PurpleCactus2/Custom-Devboard/Assets/PCB/PCB Render2.png

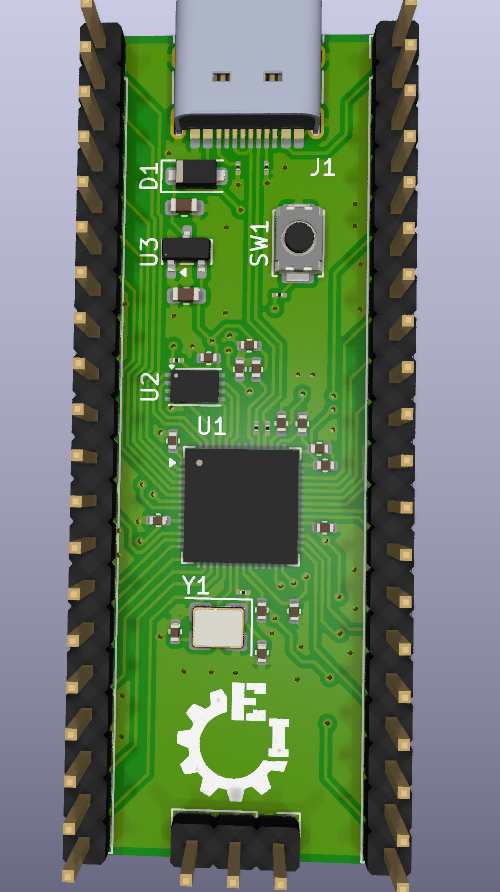
Assets/PCB/PCB Render2.png
