PurpleCactus2/Custom-Devboard/Assets/PCB/PCB Render3.png

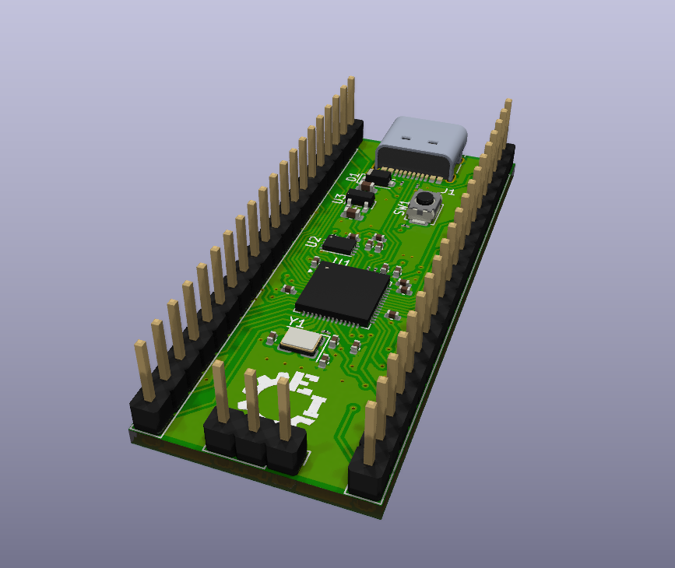
Assets/PCB/PCB Render3.png
