PurpleCactus2/Custom-Devboard/README.md

# Custom-Devboard
An RP2040 devboard meant for a completely custom and streamlined electronics development experience!
PCB Render1

## Introduction
This is a completely custom devboard made with the wonderful guide by [@Kai Pereira](https://blueprint.hackclub.com/starter-projects/devboard)

It features:

- An RP2040 microcontroller
- All 30 GPIO pins of the RP2040 broken out, with plently power and debugging pins as well
- 2MB of flash storage

## PCB and Schematic

### Schematic
My schematic uses a mostly similar layout to the one suggested in the guide, however, I have also included a diode and VSYS pin so that you can connect an external battery/power source to power the board. In addition to this, I have also changed the external pin layout a little in a way that makes more sense to me, but you'll see what I mean.

Here are a couple of screenshots of the schematic:

The RP2040 with its decoupling capacitors:<br>
Microcontroller<br>

The USB-C port (you can also see the diode I added here):<br>
USB-C<br>

The flash memory along with the BOOTSEL button:<br>
Flash<br>

The 12MHz crystal oscillator:<br>
Crystal<br>

The IO pins with a slightly changed layout:<br>
IO<br>

### PCB
This is my first time using SMD so my layout and routing are a little atrocious. But I have tried my best to keep everything as logical as possible.

Here are a couple screenshots of the PCB:

The RP2040 footprint with decoupling caps, crystal and flash:<br>
MCU Screenshot<br>

The whole board:<br>
Board Screenshot<br>

Final render:<br>
PCB Render2<br>

## BOM
|  | Item | Qty | Supplier | Cost/item | Total Cost | link |
|---|---|---|---|---|---|---|
|  | RP2040 | 1 | LCSC | $1.10 | $1.10 | [LCSC](https://www.lcsc.com/product-detail/C2040.html) |
|  | MCP1700 | 1 | LCSC | $0.44 | $0.44 | [LCSC](https://www.lcsc.com/product-detail/C39051.html) |
|  | Crystal | 1 | LCSC | $0.46 | $0.46 | [LCSC](https://www.lcsc.com/product-detail/C9002.html) |
|  | Flash memory | 1 | LCSC | $1.92 | $1.92 | [LCSC](https://www.lcsc.com/product-detail/C2456208.html) |
|  | Button | 1 | LCSC | $0.51 | $0.51 | [LCSC](https://www.lcsc.com/product-detail/C720477.html) |
|  | USB-C Port | 1 | LCSC | $0.87 | $0.87 | [LCSC](https://www.lcsc.com/product-detail/C165948.html) |
|  | Passive Components | 1 | LCSC | $1.57 | $1.57 | [100nF](https://www.lcsc.com/product-detail/C1525.html) [1uF](https://www.lcsc.com/product-detail/C2803380.html) [10uF](https://www.lcsc.com/product-detail/C1691.html) [33pF](https://www.lcsc.com/product-detail/C107005.html) [Diode](https://www.lcsc.com/product-detail/C49231016.html) [5.1KΩ](https://www.lcsc.com/product-detail/C2906874.html) [27Ω](https://www.lcsc.com/product-detail/C2909343.html) [1KΩ](https://www.lcsc.com/product-detail/C2906899.html) [10KΩ](https://www.lcsc.com/product-detail/C2906861.html) |
|  | PCB | 1 | JLCPCB | $4.10 | $4.10 | [LCSC](https://cart.jlcpcb.com/quote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) |
|  | Estimated total shipping |  |  |  | $18.94 |  |
|  | Total |  |  |  | $29.91 |  |

*I am willing to cover any extra charges that might apply*

### Cart Screenshots

LCSC Order:<br>
LCSC1<br>
LCSC2<br>
LCSC3<br>

JLCPCB Order:<br>
JLCPCB
