PurpleCactus2/Custom-Devboard/Assets/Cart Screenshots/JLCPCB.png

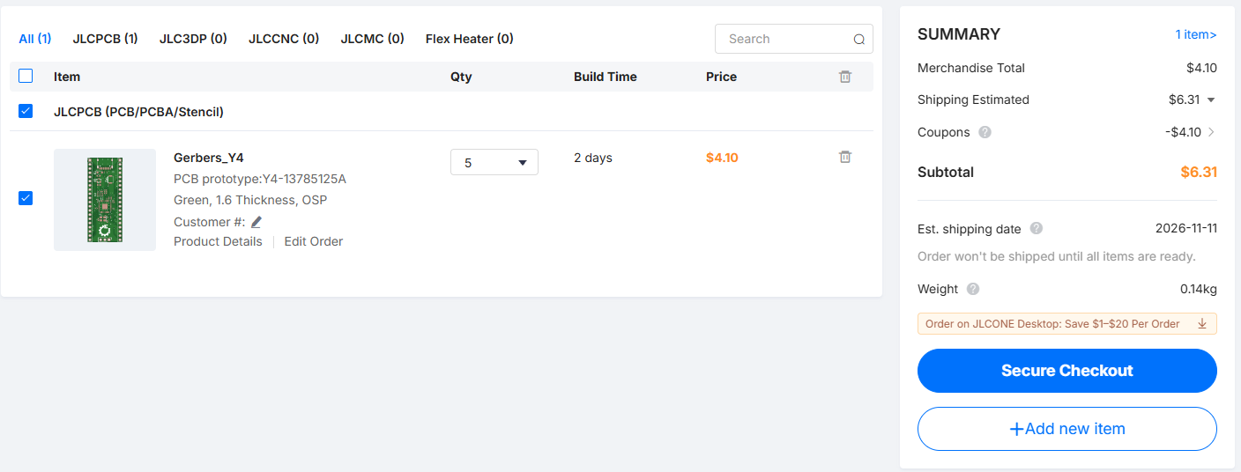
Assets/Cart Screenshots/JLCPCB.png
