PurpleCactus2/Custom-Devboard/Assets/Cart Screenshots/LCSC1.png

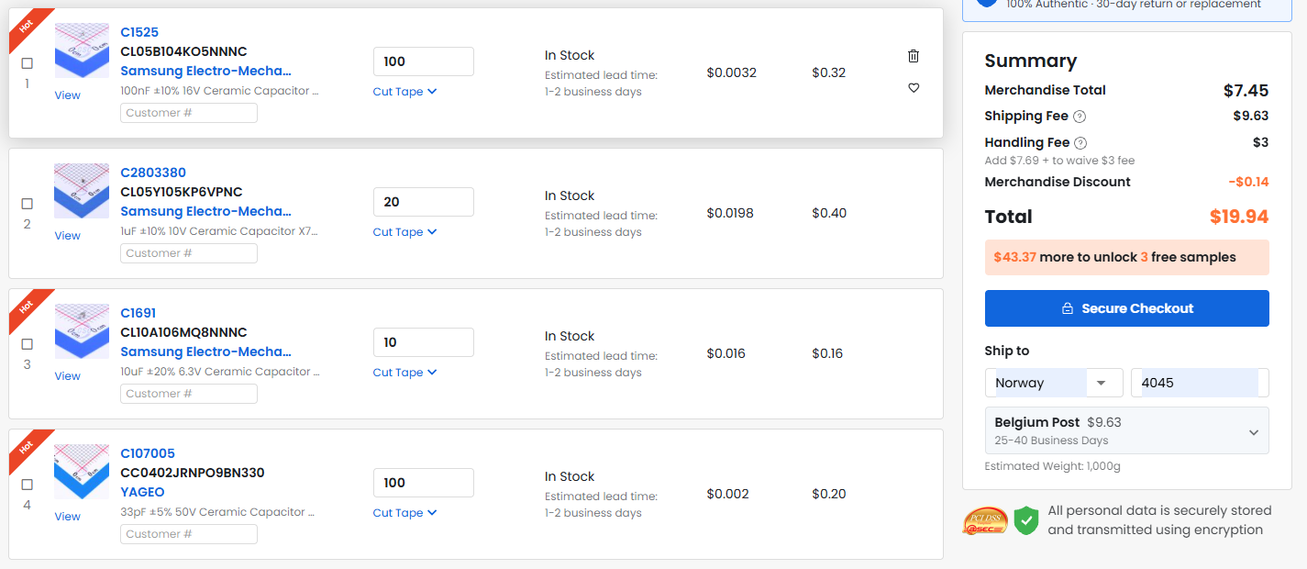
Assets/Cart Screenshots/LCSC1.png
