PurpleCactus2/Custom-Devboard/Assets/Cart Screenshots/LCSC2.png

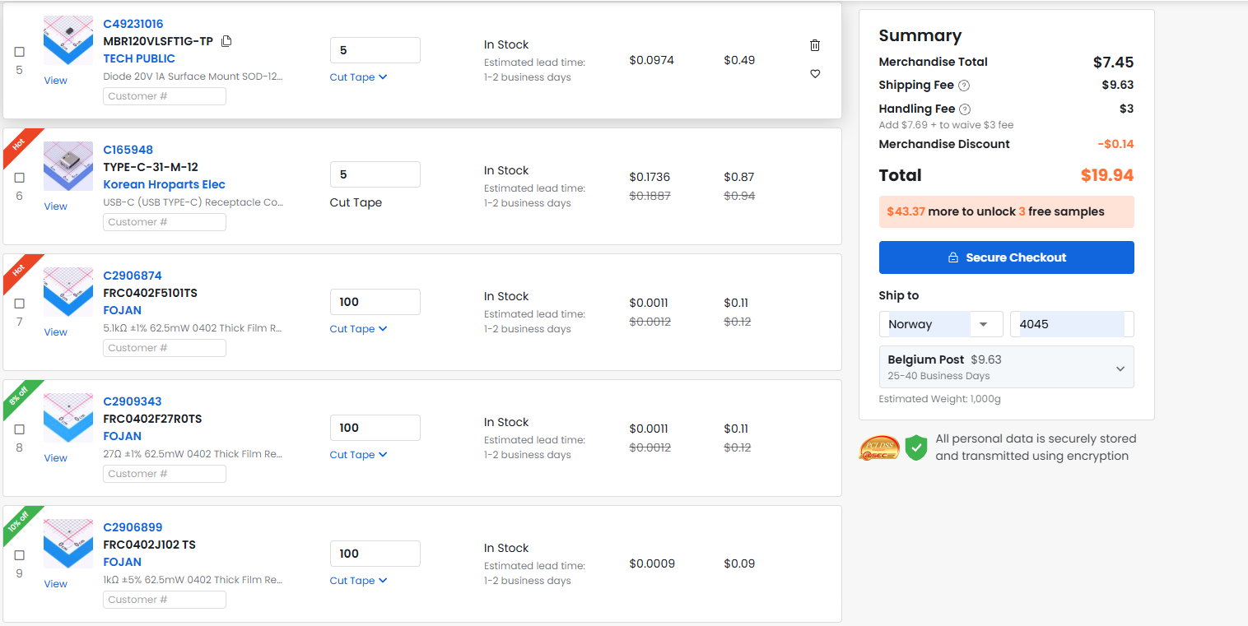
Assets/Cart Screenshots/LCSC2.png
