PurpleCactus2/Custom-Devboard/Assets/Cart Screenshots/LCSC3.png

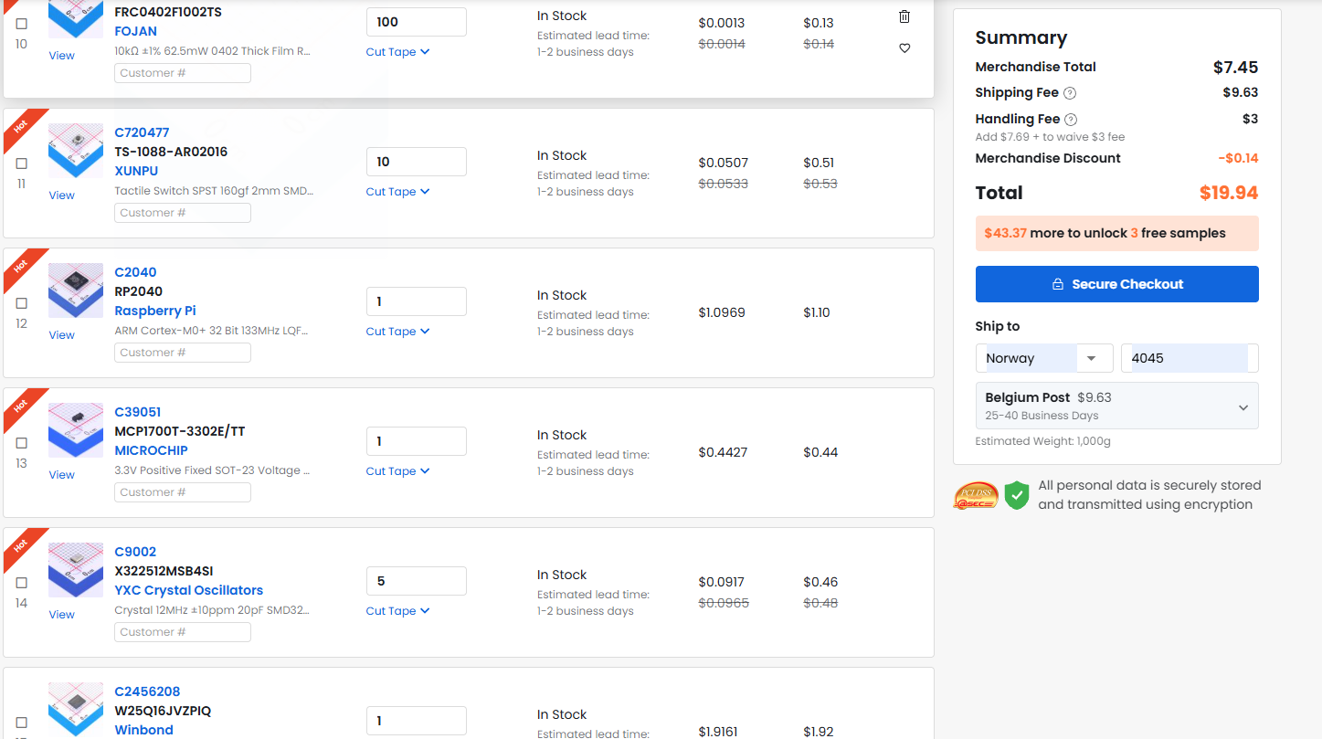
Assets/Cart Screenshots/LCSC3.png
