PurpleCactus2/Custom-Devboard/Assets/PCB/Board Screenshot .png

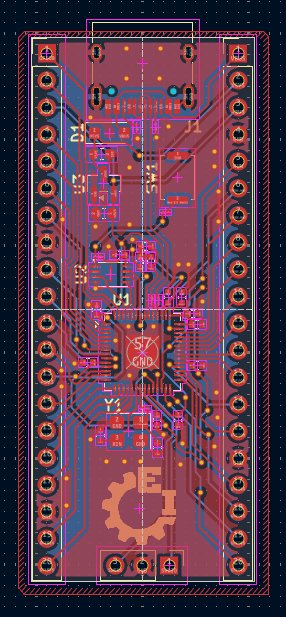
Assets/PCB/Board Screenshot .png
