PurpleCactus2/Custom-Devboard/Assets/PCB/MCU Screenshot.png

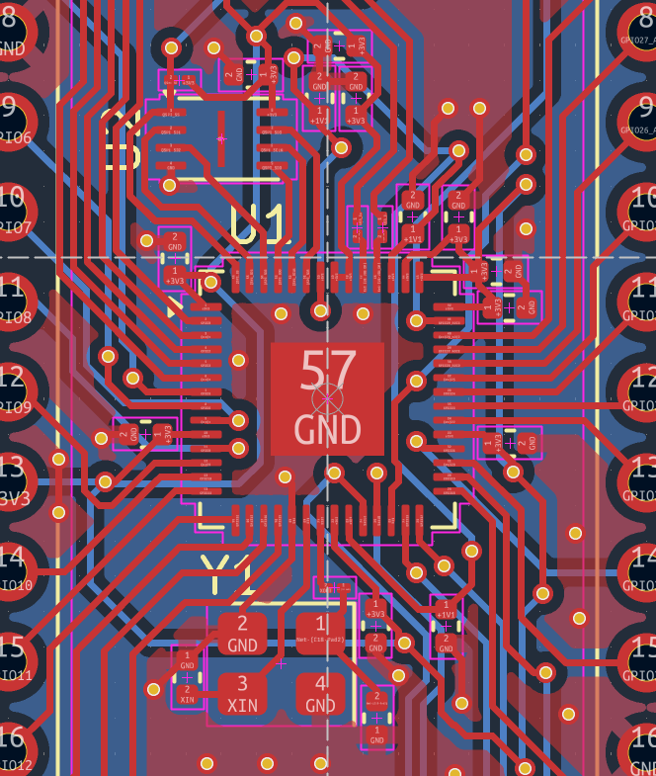
Assets/PCB/MCU Screenshot.png
