PurpleCactus2/Custom-Devboard/Assets/PCB/PCB Render1.png

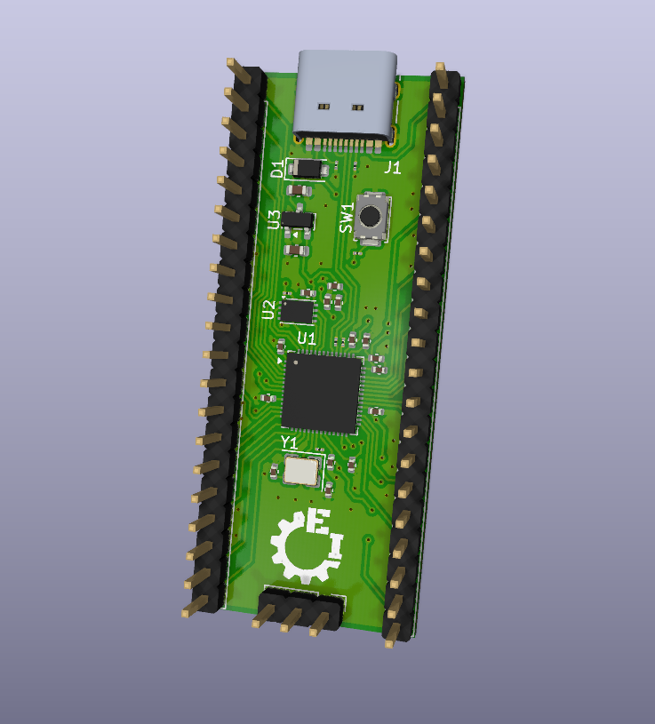
Assets/PCB/PCB Render1.png
