PurpleCactus2/Custom-Devboard/Assets/Schematic/Crystal.png

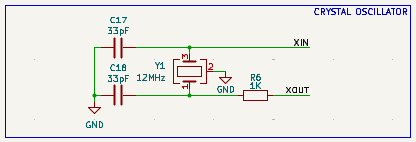
Assets/Schematic/Crystal.png
