PurpleCactus2/Custom-Devboard/Assets/Schematic/Flash.png

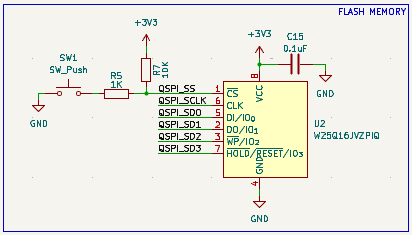
Assets/Schematic/Flash.png
