PurpleCactus2/Custom-Devboard/Assets/Schematic/IO.png

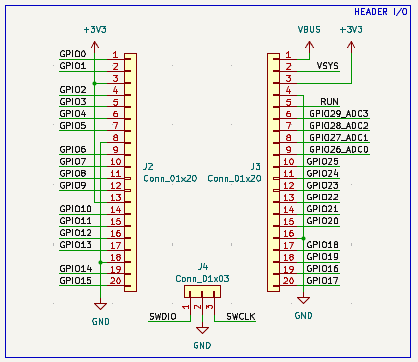
Assets/Schematic/IO.png
