PurpleCactus2/Custom-Devboard/Assets/Schematic/Microcontroller.png

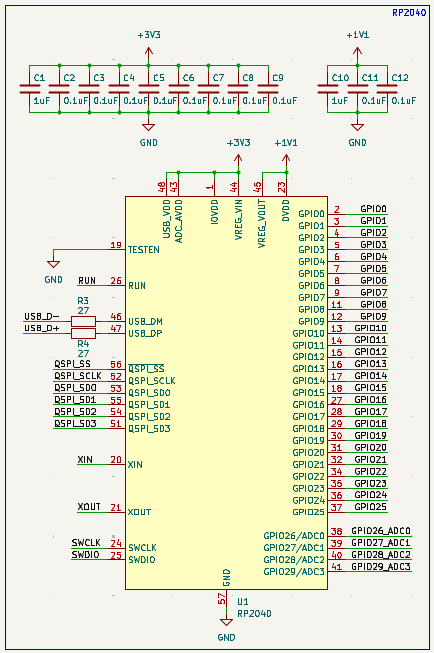
Assets/Schematic/Microcontroller.png
