PurpleCactus2/Custom-Devboard/Assets/Schematic/USB-C.png

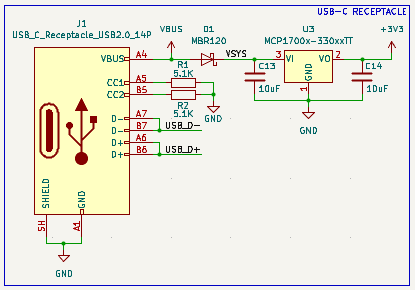
Assets/Schematic/USB-C.png
