PurpleCactus2/Custom-Devboard/BOM.csv

Item | Qty | Supplier | Cost/item | Total Cost | link
RP2040 | 1 | LCSC | $1.10 | $1.10 | https://www.lcsc.com/product-detail/C2040.html
MCP1700 | 1 | LCSC | $0.44 | $0.44 | https://www.lcsc.com/product-detail/C39051.html
Crystal | 1 | LCSC | $0.46 | $0.46 | https://www.lcsc.com/product-detail/C9002.html
Flash memory | 1 | LCSC | $1.92 | $1.92 | https://www.lcsc.com/product-detail/C2456208.html
Button | 1 | LCSC | $0.51 | $0.51 | https://www.lcsc.com/product-detail/C720477.html
USB-C Port | 1 | LCSC | $0.87 | $0.87 | https://www.lcsc.com/product-detail/C165948.html
Passive Components | 1 | LCSC | $1.57 | $1.57 | https://www.lcsc.com/product-detail/C1525.html
PCB | 1 | JLCPCB | $4.10 | $4.10 | https://cart.jlcpcb.com/quote?stencilLayer=2&stencilWidth=100&stencilLength=100&stencilCounts=5&plateType=1
Estimated total shipping | 1 |  |  | $18.94
