PurpleCactus2/Custom-Devboard/Assets/Cart Screenshots/LCSC Cart.csv

Index | LCSC# | MPN | Manufacturer | Package | Customer # | Description | RoHS | Quantity | MOQ | Multiple | Unit Price($) | Extended Price($) | Product Link
1 | C1525 | CL05B104KO5NNNC | Samsung Electro-Mechanics | 0402 |  | 100nF ±10% 16V Ceramic Capacitor X7R 0402 | yes | 100 | 100 | 100 | 0.0032 | 0.32 | https://www.lcsc.com/product-detail/C1525.html
2 | C2803380 | CL05Y105KP6VPNC | Samsung Electro-Mechanics | 0402 |  | 1uF ±10% 10V Ceramic Capacitor X7S 0402 | yes | 20 | 20 | 20 | 0.0198 | 0.40 | https://www.lcsc.com/product-detail/C2803380.html
3 | C1691 | CL10A106MQ8NNNC | Samsung Electro-Mechanics | 0603 |  | 10uF ±20% 6.3V Ceramic Capacitor X5R 0603 | yes | 10 | 10 | 10 | 0.0160 | 0.16 | https://www.lcsc.com/product-detail/C1691.html
4 | C107005 | CC0402JRNPO9BN330 | YAGEO | 0402 |  | 33pF ±5% 50V Ceramic Capacitor NP0 0402 | yes | 100 | 100 | 100 | 0.0020 | 0.20 | https://www.lcsc.com/product-detail/C107005.html
5 | C49231016 | MBR120VLSFT1G-TP | TECH PUBLIC | SOD-123F |  | Diode 20V 1A Surface Mount SOD-123F | yes | 5 | 5 | 5 | 0.0974 | 0.49 | https://www.lcsc.com/product-detail/C49231016.html
6 | C165948 | TYPE-C-31-M-12 | Korean Hroparts Elec | SMD |  | USB-C (USB TYPE-C) Receptacle Connector 16 Position Surface Mount | yes | 5 | 5 | 5 | 0.1736 | 0.87 | https://www.lcsc.com/product-detail/C165948.html
7 | C2906874 | FRC0402F5101TS | FOJAN | 0402 |  | 5.1kΩ ±1% 62.5mW 0402 Thick Film Resistor | yes | 100 | 100 | 100 | 0.0011 | 0.11 | https://www.lcsc.com/product-detail/C2906874.html
8 | C2909343 | FRC0402F27R0TS | FOJAN | 0402 |  | 27Ω ±1% 62.5mW 0402 Thick Film Resistor | yes | 100 | 100 | 100 | 0.0011 | 0.11 | https://www.lcsc.com/product-detail/C2909343.html
9 | C2906899 | FRC0402J102 TS | FOJAN | 0402 |  | 1kΩ ±5% 62.5mW 0402 Thick Film Resistor | yes | 100 | 100 | 100 | 0.0009 | 0.09 | https://www.lcsc.com/product-detail/C2906899.html
10 | C2906861 | FRC0402F1002TS | FOJAN | 0402 |  | 10kΩ ±1% 62.5mW 0402 Thick Film Resistor | yes | 100 | 100 | 100 | 0.0013 | 0.13 | https://www.lcsc.com/product-detail/C2906861.html
11 | C720477 | TS-1088-AR02016 | XUNPU | SMD,4x3mm |  | Tactile Switch SPST 160gf 2mm SMD (SMT) Tab 4mm x 3mm Surface Mount | yes | 10 | 10 | 10 | 0.0507 | 0.51 | https://www.lcsc.com/product-detail/C720477.html
12 | C2040 | RP2040 | Raspberry Pi | LQFN-56(7x7) |  | ARM Cortex-M0+ 32 Bit 133MHz LQFN-56(7x7) Microcontrollers | yes | 1 | 1 | 1 | 1.0969 | 1.10 | https://www.lcsc.com/product-detail/C2040.html
13 | C39051 | MCP1700T-3302E/TT | MICROCHIP | SOT-23 |  | 3.3V Positive Fixed SOT-23 Voltage Regulators - Linear, Low Drop Out (LDO) Regulators RoHS | yes | 1 | 1 | 1 | 0.4427 | 0.44 | https://www.lcsc.com/product-detail/C39051.html
14 | C9002 | X322512MSB4SI | YXC Crystal Oscillators | SMD3225-4P |  | Crystal 12MHz ±10ppm 20pF SMD3225-4P | yes | 5 | 5 | 5 | 0.0917 | 0.46 | https://www.lcsc.com/product-detail/C9002.html
15 | C2456208 | W25Q16JVZPIQ | Winbond | WSON-8-EP(5x6) |  | 16Mbit 2.7V~3.6V 133MHz SPI WSON-8-EP(5x6) Memory RoHS | yes | 1 | 1 | 1 | 1.9161 | 1.92 | https://www.lcsc.com/product-detail/C2456208.html
