PurpleCactus2/Custom-Devboard/PCB/SchematicPDF.pdf

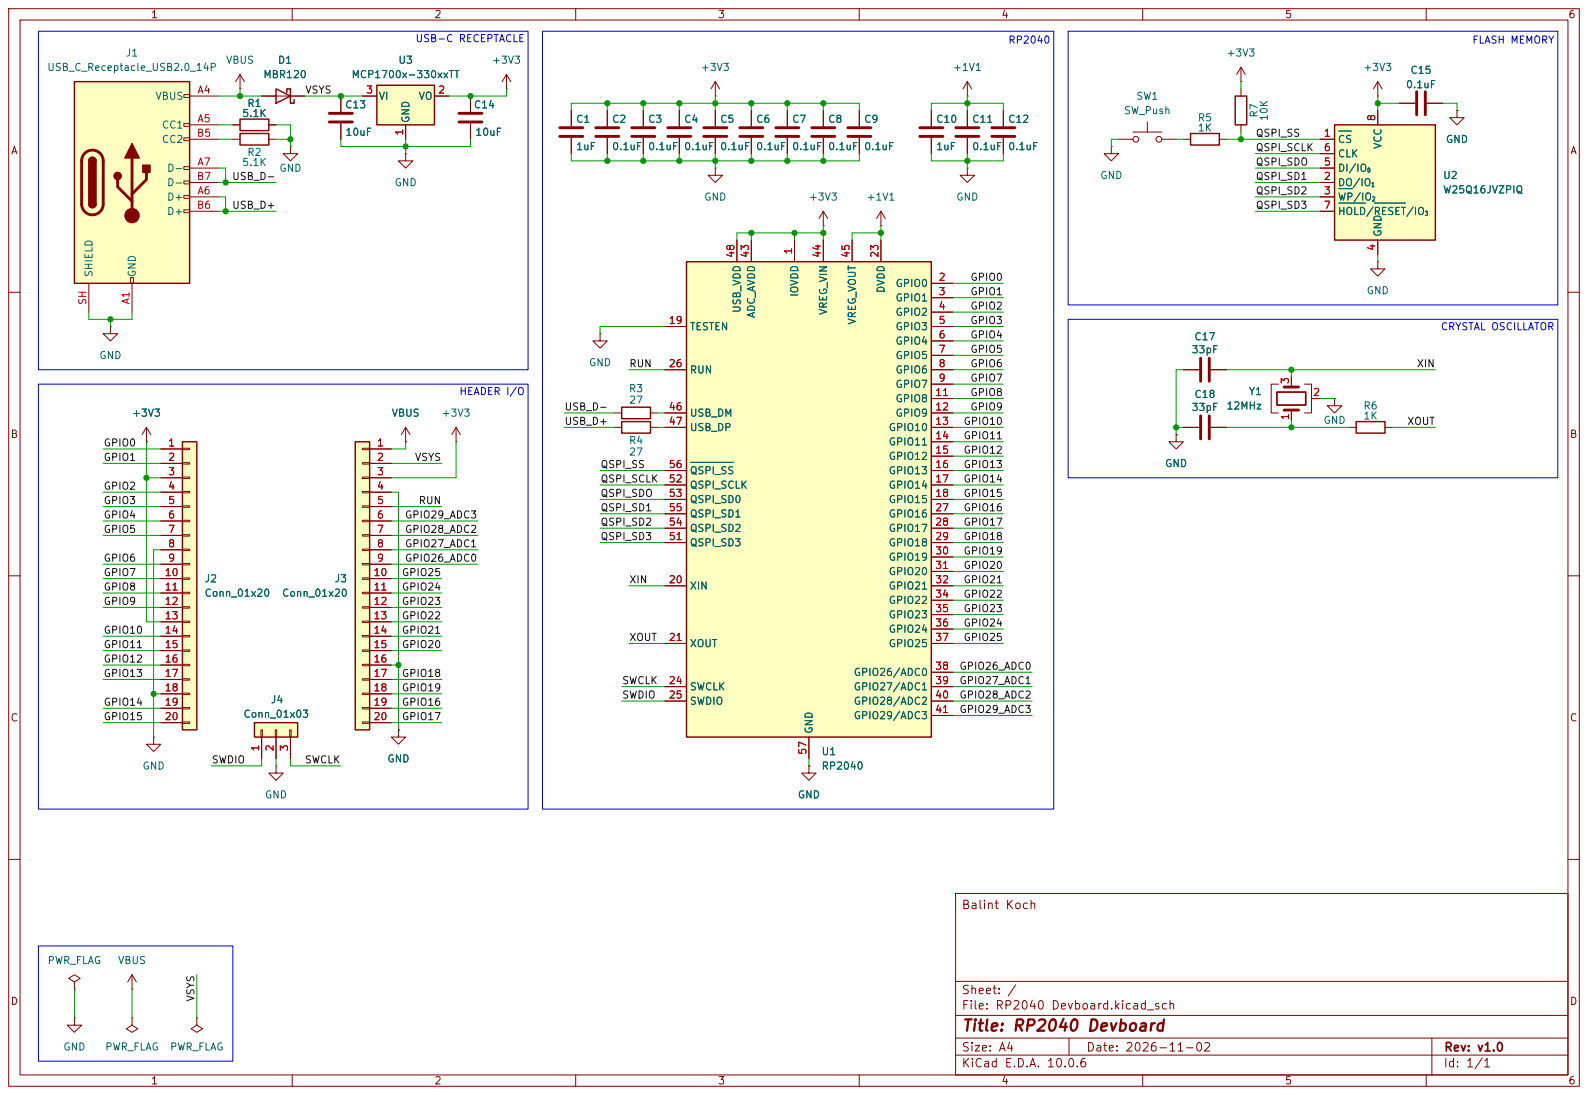
[picture p15: page 1]

4 DI/IO0 5 CLK 6 HOLD/RESET/IO3 7 VCC

PWR_FLAG GND | VBUS PWR_FLAG

Size: A4 | Rev: v1.0
KiCad E.D.A. 10.0.6 | Id: 1/1
