PurpleCactus2/Custom-Devboard/PCB/Devboard PCB.kicad_pcb

## KiCad design PCB/Devboard PCB.kicad_pcb (2026-11-09)

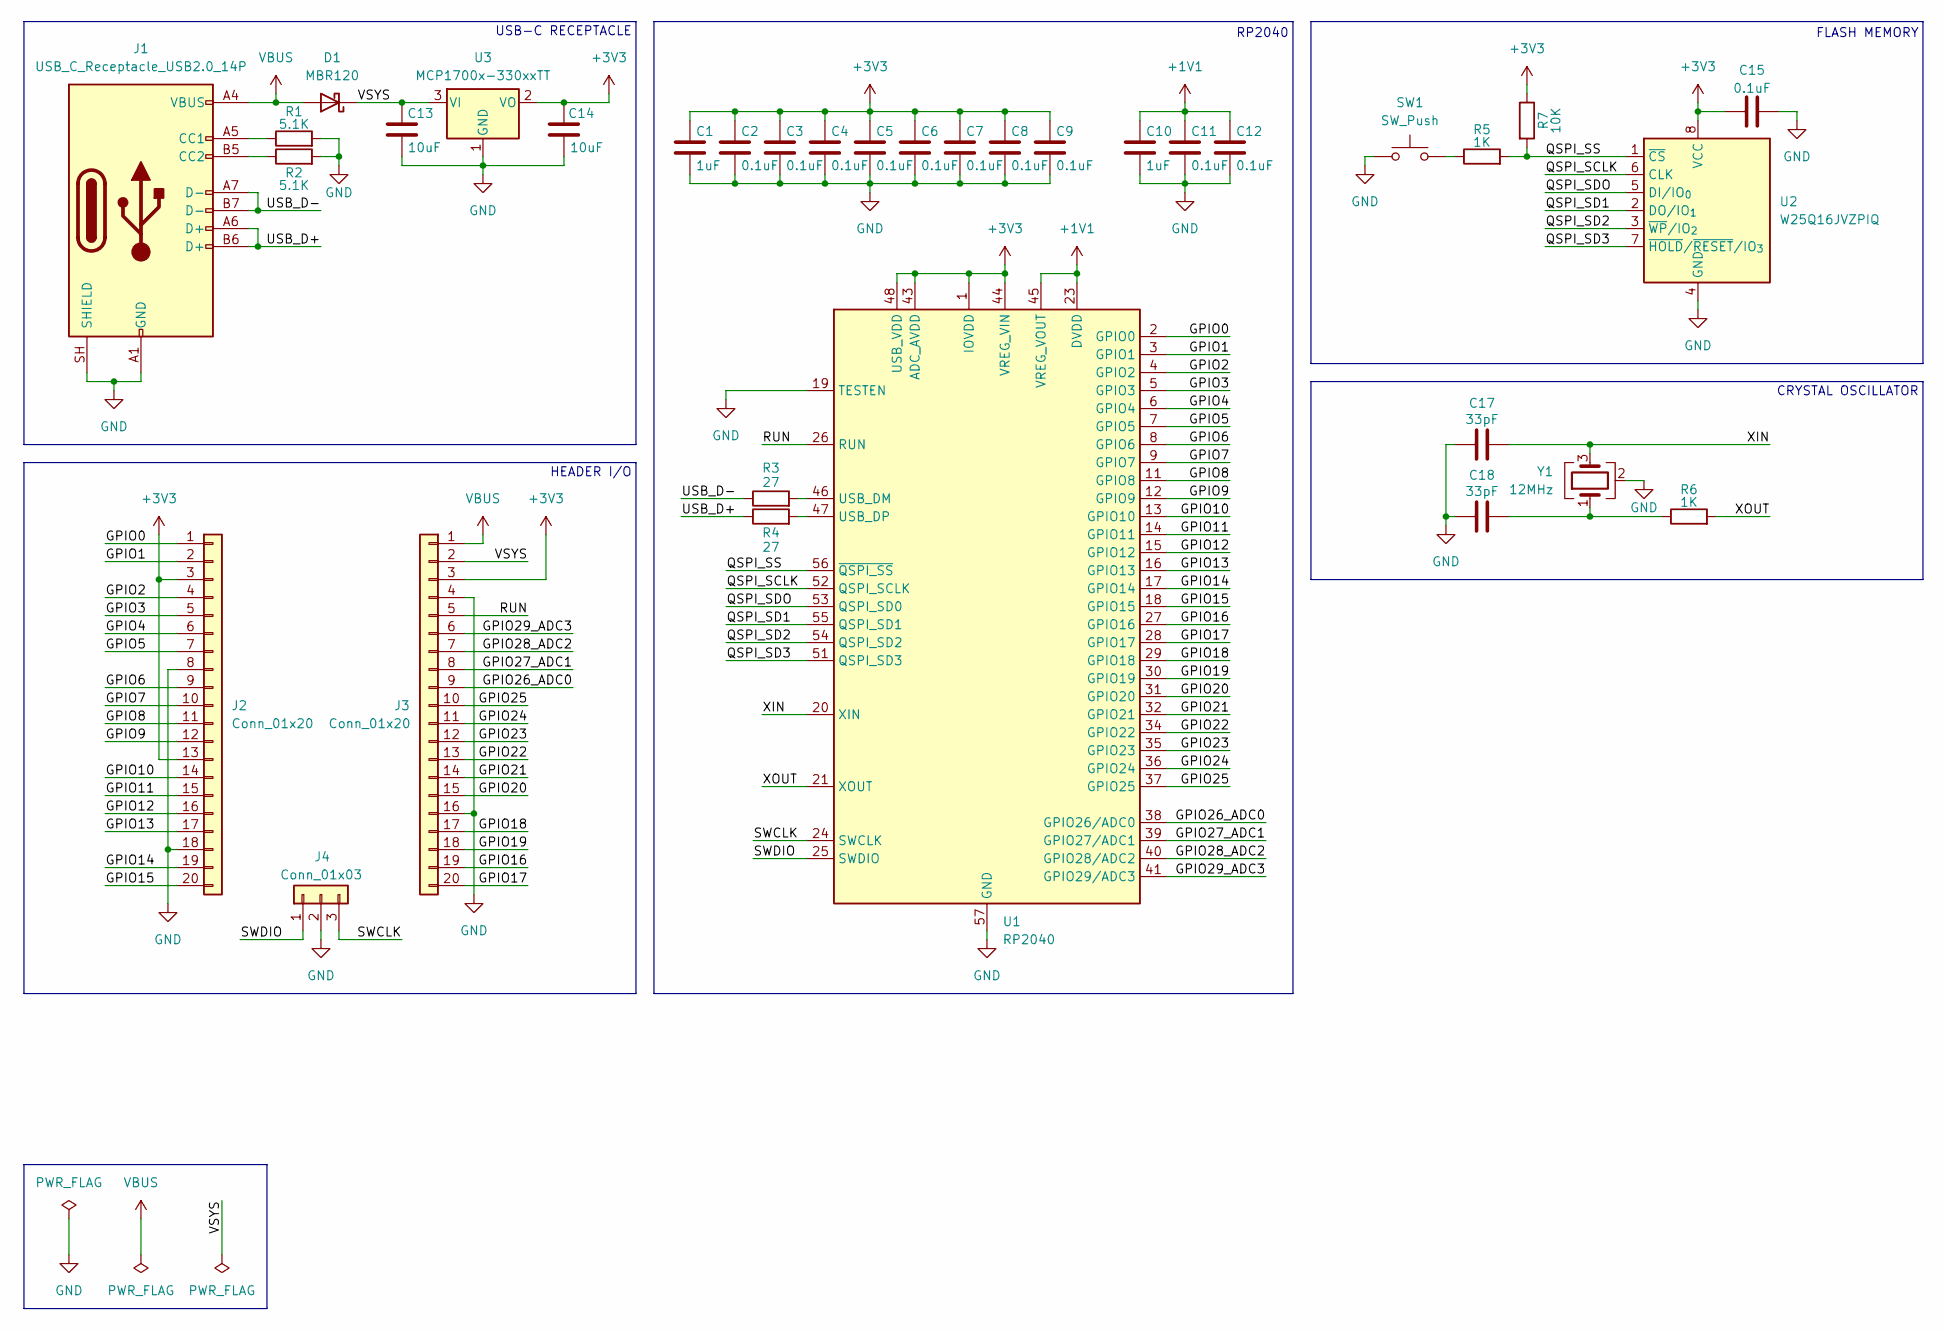
[picture p16: schematic Devboard Schematic.kicad_sch, RP2040 Devboard]

Parts:
C1, C10: 1uF; C_0402_1005Metric
C2, C3, C4, C5, C6, C7, C8, C9, C11, C12, C15: 0.1uF; C_0402_1005Metric
C13, C14: 10uF; C_0603_1608Metric
C17, C18: 33pF; C_0402_1005Metric
D1: MBR120; D_SOD-123F
J1: USB_C_Receptacle_USB2.0_14P; USB_C_Receptacle_HRO_TYPE-C-31-M-12
J2, J3: Conn_01x20; PinHeader_1x20_P2.54mm_Vertical
J4: Conn_01x03; PinHeader_1x03_P2.54mm_Vertical
R1, R2: 5.1K; R_01005_0402Metric
R3, R4: 27; R_01005_0402Metric
R5, R6: 1K; R_01005_0402Metric
R7: 10K; R_01005_0402Metric
SW1: SW_Push; SW_Push_SPST_NO_Alps_SKRK
U1: RP2040; QFN-56-1EP_7x7mm_P0.4mm_EP3.2x3.2mm
U2: W25Q16JVZPIQ; Winbond_USON-8-1EP_3x2mm_P0.5mm_EP0.2x1.6mm
U3: MCP1700x-330xxTT; SOT-23
Y1: 12MHz; Crystal_SMD_3225-4Pin_3.2x2.5mm

Connections:
+1V1: C10.1, C11.1, C12.1, U1.23 (DVDD), U1.45 (VREG_VOUT), U1.50 (DVDD)
+3V3: C1.1, C2.1, C3.1, C4.1, C5.1, C6.1, C7.1, C8.1, C9.1, C14.1, C15.1, J2.3, J2.13, J3.3, R7.1, U1.1 (IOVDD), U1.10 (IOVDD), U1.22 (IOVDD), U1.33 (IOVDD), U1.42 (IOVDD), U1.43 (ADC_AVDD), U1.44 (VREG_VIN), U1.48 (USB_VDD), U1.49 (IOVDD), U2.8 (VCC), U3.2 (VO)
/GPIO0: J2.1, U1.2 (GPIO0)
/GPIO1: J2.2, U1.3 (GPIO1)
/GPIO2: J2.4, U1.4 (GPIO2)
/GPIO3: J2.5, U1.5 (GPIO3)
/GPIO4: J2.6, U1.6 (GPIO4)
/GPIO5: J2.7, U1.7 (GPIO5)
/GPIO6: J2.9, U1.8 (GPIO6)
/GPIO7: J2.10, U1.9 (GPIO7)
/GPIO8: J2.11, U1.11 (GPIO8)
/GPIO9: J2.12, U1.12 (GPIO9)
/GPIO10: J2.14, U1.13 (GPIO10)
/GPIO11: J2.15, U1.14 (GPIO11)
/GPIO12: J2.16, U1.15 (GPIO12)
/GPIO13: J2.17, U1.16 (GPIO13)
/GPIO14: J2.19, U1.17 (GPIO14)
/GPIO15: J2.20, U1.18 (GPIO15)
/GPIO16: J3.19, U1.27 (GPIO16)
/GPIO17: J3.20, U1.28 (GPIO17)
/GPIO18: J3.17, U1.29 (GPIO18)
/GPIO19: J3.18, U1.30 (GPIO19)
/GPIO20: J3.15, U1.31 (GPIO20)
/GPIO21: J3.14, U1.32 (GPIO21)
/GPIO22: J3.13, U1.34 (GPIO22)
/GPIO23: J3.12, U1.35 (GPIO23)
/GPIO24: J3.11, U1.36 (GPIO24)
/GPIO25: J3.10, U1.37 (GPIO25)
/GPIO26_ADC0: J3.9, U1.38 (GPIO26/ADC0)
/GPIO27_ADC1: J3.8, U1.39 (GPIO27/ADC1)
/GPIO28_ADC2: J3.7, U1.40 (GPIO28/ADC2)
/GPIO29_ADC3: J3.6, U1.41 (GPIO29/ADC3)
/QSPI_SCLK: U1.52 (QSPI_SCLK), U2.6 (CLK)
/QSPI_SD1: U1.55 (QSPI_SD1), U2.2 (DO/IO_{1})
/QSPI_SD2: U1.54 (QSPI_SD2), U2.3 (~WP/IO_{2})
/QSPI_SD3: U1.51 (QSPI_SD3), U2.7 (~HOLD/~RESET/IO_{3})
/QSPI_SDO: U1.53 (QSPI_SD0), U2.5 (DI/IO_{0})
/QSPI_SS: R5.2, R7.2, U1.56 (~QSPI_SS), U2.1 (~CS)
/RUN: J3.5, U1.26 (RUN)
/SWCLK: J4.3, U1.24 (SWCLK)
/SWDIO: J4.1, U1.25 (SWDIO)
/USB_D+: J1.A6 (D+), J1.B6 (D+), R4.1
/USB_D-: J1.A7 (D-), J1.B7 (D-), R3.1
/VSYS: C13.1, D1.1 (K), J3.2, U3.3 (VI)
/XIN: C17.2, U1.20 (XIN), Y1.3
/XOUT: R6.2, U1.21 (XOUT)
GND: C1.2, C2.2, C3.2, C4.2, C5.2, C6.2, C7.2, C8.2, C9.2, C10.2, C11.2, C12.2, C13.2, C14.2, C15.2, C17.1, C18.1, J1.A1 (GND), J1.A12 (GND), J1.B1 (GND), J1.B12 (GND), J1.SH (SHIELD), J2.8, J2.18, J3.4, J3.16, J4.2, R1.2, R2.2, SW1.1, U1.19 (TESTEN), U1.57 (GND), U2.4 (GND), U3.1 (GND), Y1.2 (G), Y1.4 (G)
unnamed: C18.2, R6.1, Y1.1
unnamed: J1.A5 (CC1), R1.1
unnamed: J1.B5 (CC2), R2.1
unnamed: R5.1, SW1.2
unnamed: R3.2, U1.46 (USB_DM)
unnamed: R4.2, U1.47 (USB_DP)
VBUS: D1.2 (A), J1.A4 (VBUS), J1.A9 (VBUS), J1.B4 (VBUS), J1.B9 (VBUS), J3.1

Notes on the sheet:
USB-C RECEPTACLE
HEADER I/O
RP2040
CRYSTAL OSCILLATOR
FLASH MEMORY

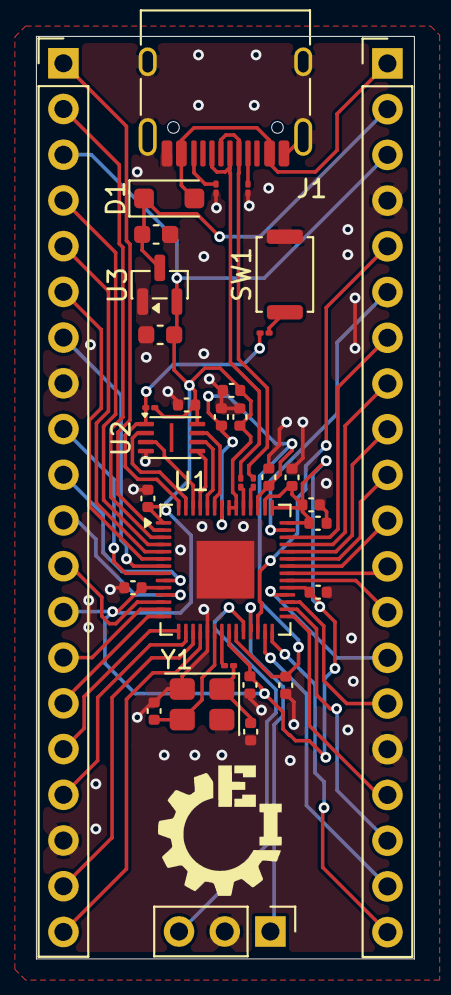
[picture p17: board Devboard PCB.kicad_pcb from above]

Board: 2 copper layers, 21.0 x 51.2 mm, 34 parts (0 on the bottom side), 54 nets.
