PurpleCactus2/Custom-Devboard/JOURNAL.md

# Custom Devboard: devlog

<!-- Generated by Half Life from project da2gd1uc3pobl39w0nm68g7f. Edits here are overwritten on the next sync. -->
<!-- Generated: 2026-11-09T01:05:24.286Z -->

> [!NOTE]
> This devlog is mirrored from [Half Life](https://halflife.hackclub.com) ([open the project](https://halflife.hackclub.com/projects/da2gd1uc3pobl39w0nm68g7f)). Editing it here will not change the platform's copy, and the next sync overwrites this file.

> An RP2040 devboard meant for a completely custom and streamlined electronics development experience!

| Week | Tier | Hours logged | Entries |
| --- | --- | --- | --- |
| Week 5 | Tier 1 | 18.32h | 8 |

## Contents

1. [2026-11-02: Starting the schematic and researching components](#2026-11-02-starting-the-schematic-and-researching-components)
2. [2026-11-03: Working more on the schematic, at this point I  am thinking about battery power integration and pin layout options](#2026-11-03-working-more-on-the-schematic-at-this-point-i-am-)
3. [2026-11-05: Finishing the schematic itself, footprints still need to be added though.](#2026-11-05-finishing-the-schematic-itself-footprints-still-n)
4. [2026-11-06: Assigning all footprints and researching components](#2026-11-06-assigning-all-footprints-and-researching-componen)
5. [2026-11-06: Starting the PCB itself; making the rough layout](#2026-11-06-starting-the-pcb-itself-making-the-rough-layout)
6. [2026-11-07: Figuring out the layout and making a draft before routing](#2026-11-07-figuring-out-the-layout-and-making-a-draft-before)
7. [2026-11-08: Completely routing and finishing the PCB, also exporting screenshots and production files](#2026-11-08-completely-routing-and-finishing-the-pcb-also-exp)
8. [2026-11-08: Creating the BOM, finishing up the repo](#2026-11-08-creating-the-bom-finishing-up-the-repo)

## Design

### 2026-11-02: Starting the schematic and researching components

**1.42h**

Starting the schematic and researching components

[Timelapse](https://lookout.hackclub.com/api/media/925ab663-7c3c-4cf1-8395-ae1f1cbb7657/video.mp4)

### 2026-11-03: Working more on the schematic, at this point I  am thinking about battery power integration and pin layout options

**1.87h**

Working more on the schematic, at this point I  am thinking about battery power integration and pin layout options

[Timelapse](https://lookout.hackclub.com/api/media/6d62385f-a4f2-4cc5-9b7e-b176e370cad0/video.mp4)

### 2026-11-05: Finishing the schematic itself, footprints still need to be added though.

**1.83h**

Finishing the schematic itself, footprints still need to be added though.

[Timelapse](https://lookout.hackclub.com/api/media/b3bb118c-b74c-4b55-bb42-f0f0fb4d1279/video.mp4)

### 2026-11-06: Assigning all footprints and researching components

**0.83h**

Assigning all footprints and researching components

[Timelapse](https://lookout.hackclub.com/api/media/259da895-8cb9-4fc1-8a30-1e06dd4a9972/video.mp4)

### 2026-11-06: Starting the PCB itself; making the rough layout

**1.1h**

Starting the PCB itself; making the rough layout

[Timelapse](https://lookout.hackclub.com/api/media/eb2cb23d-4d80-41fe-8949-f3d2290ab052/video.mp4)

### 2026-11-07: Figuring out the layout and making a draft before routing

**3.08h**

Figuring out the layout and making a draft before routing

[Timelapse](https://lookout.hackclub.com/api/media/c63c552b-099d-4d89-94f0-52aa09d9ea50/video.mp4)

### 2026-11-08: Completely routing and finishing the PCB, also exporting screenshots and production files

**6.32h**

Completely routing and finishing the PCB, also exporting screenshots and production files

[Timelapse](https://lookout.hackclub.com/api/media/04564232-4837-4f76-be77-d68fe7ccf6e4/video.mp4)

### 2026-11-08: Creating the BOM, finishing up the repo

**1.87h**

Creating the BOM, finishing up the repo

[Timelapse](https://lookout.hackclub.com/api/media/fcdc3f62-8d5c-4fec-b241-d849b5fd145c/video.mp4)
