PurpleCactus2/Custom-Devboard/(commit log)

2026-11-08 Sync Custom Devboard from Half Life
    [BOM.csv]
2026-11-09 Update README with extra charges note and screenshots
    Added a note about covering extra charges and included cart screenshots for LCSC and JLCPCB orders.
